JordinOverton/Learnsat_Hardware/README.md

# LearnSAT Hardware GitHub Repository

## All files related to the OBC, Boba, and PoBoI are located in their respective folders

## Please ensure all commits have MEANINGFUL descriptions behind what has been changed
