JordinOverton/Learnsat_Hardware/BoBa/BoBa.kicad_pcb

## KiCad design BoBa/BoBa.kicad_pcb (2026-11-11)

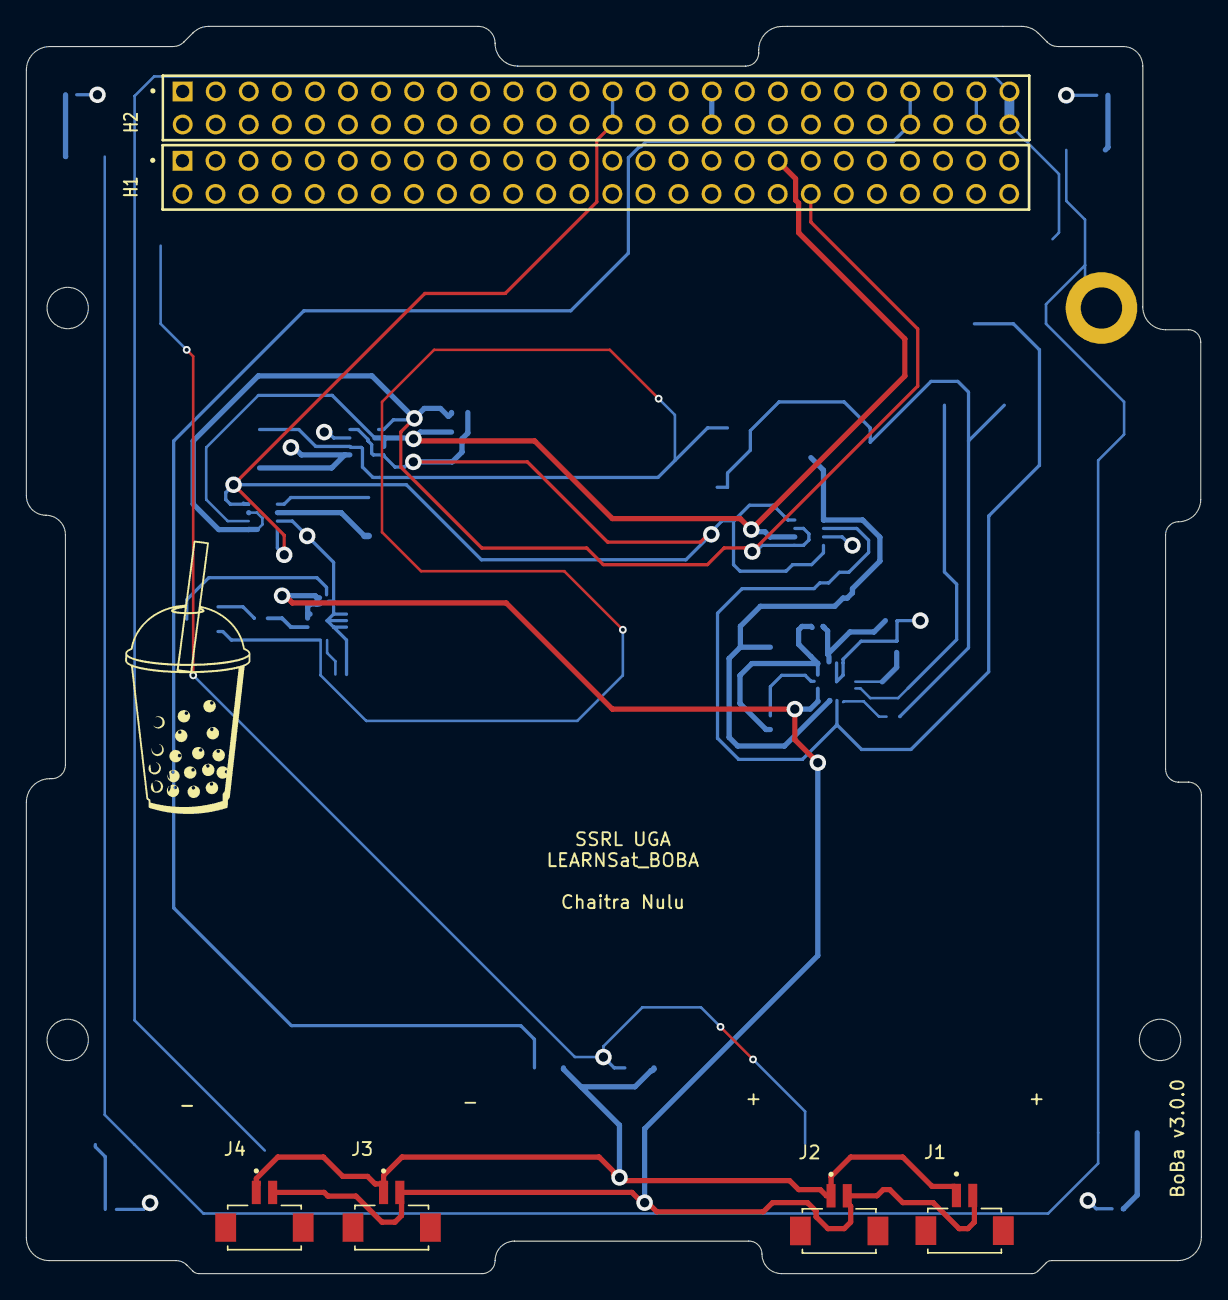
[picture p1: board BoBa.kicad_pcb from above]

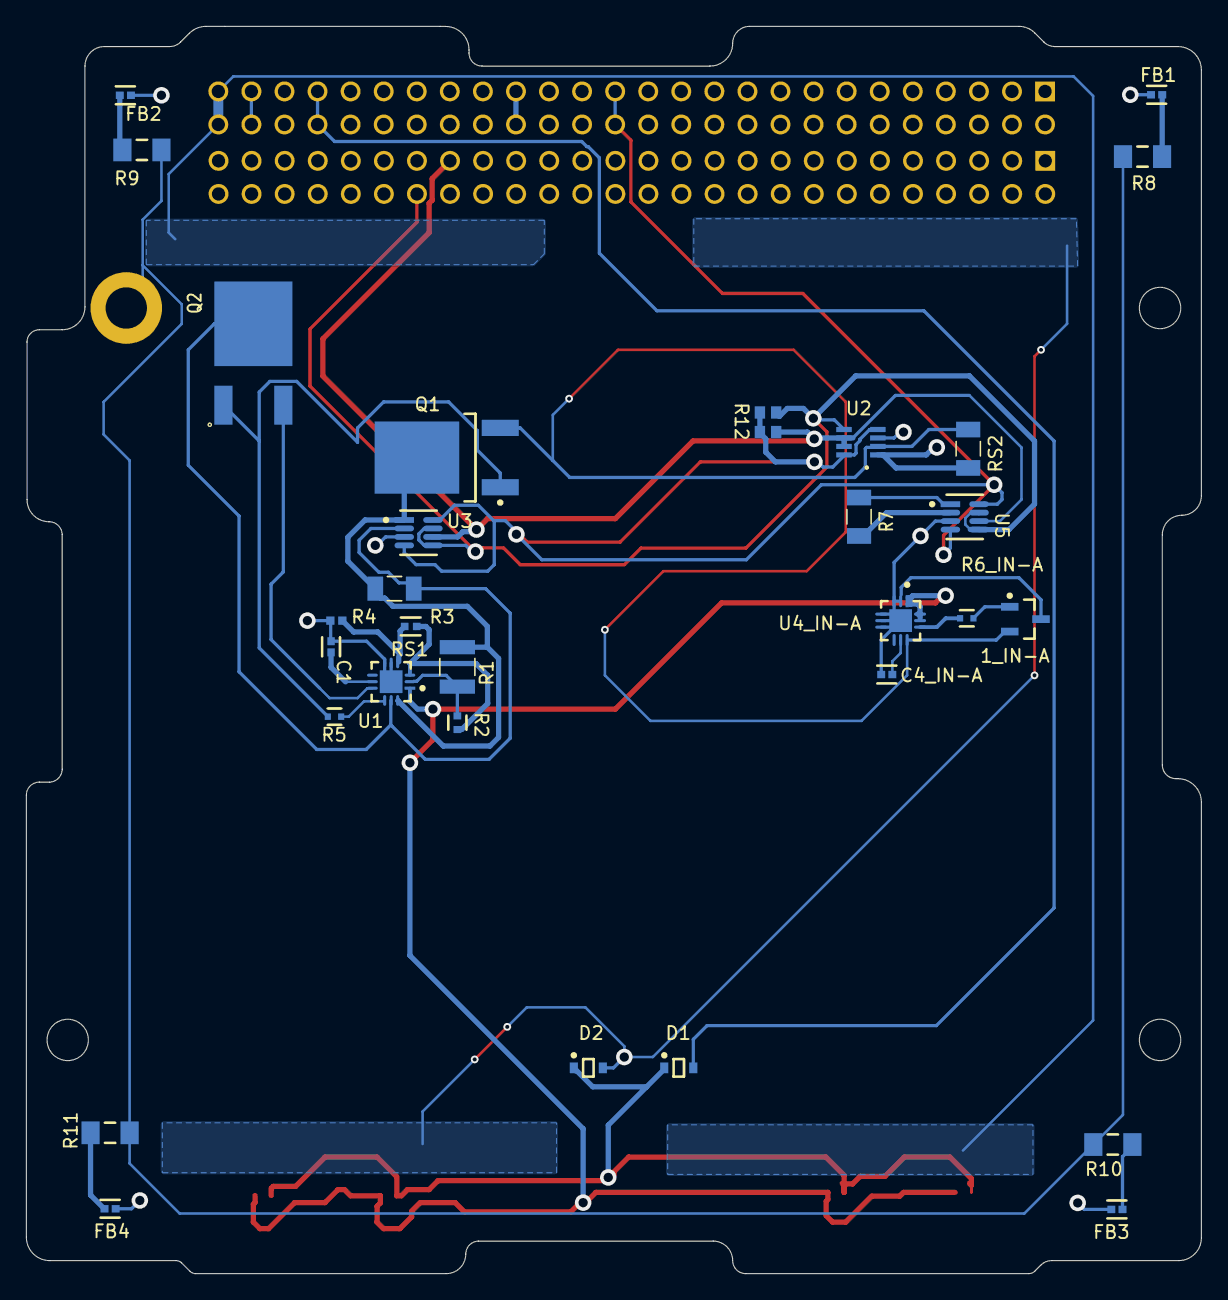
[picture p2: board BoBa.kicad_pcb from below]

Board: 4 copper layers, 90.3 x 95.8 mm, 37 parts (31 on the bottom side), 31 nets.

Parts:
1_IN-A: 2N7002; INF-PG-SOT23_M
  : CRCW06034K70FKTA; RESC1609X50X30NL10T20
C1, C4_IN-A: GRM155R71H472KA01D; FP-GRM155-0_05-IPC_B
D1, D2: BAT54HT1G; ONSC-SOD-323-2-477-02_V
FB1, FB2, FB3, FB4: BLM15AG102SN1D; FP-BLM15-0_05-IPC_B
H1, H2: SSQ-126-X-G-D; SAMTEC_SSQ-126-X-G-D
J1, J2, J3, J4: DF13C-2P-1.25V(21); HRS_DF13C-2P-1.25V(21)
Q1: FQD13N06LTM; FAIR-TO-252-3_V
Q2: FQD13N06LTM; TO229P991X239-3N
R1: CRCW1210900RFKTA; RESC3225X60N
R2: RG1005N-202-B-T5; FP-RG1005-MFG
R3: RG1005N-183-W-T5; FP-RG1005-IPC_B
R4: 96kOhm Resistor; CAPC1005X06N
R5, R6_IN-A: ERJ-2RKF10R0X; FP-ERJ2RK-MFG
R7: PE1206DRM470R025L1; RESC3216X89N
R8, R9, R10, R11: Resistor 1k +/-1% 1206 250 mW; RESC3116X70X50ML13T20
R12: CRCW06034K70FKTA; RESC1609X50X30NL10T20
RS1, RS2: PE1206DRM470R025L; RESC3216X89N
U1: LTC4231HUD-2#TRPBF; FP-UD-12-05-08-1855-IPC_B
U2: INA219; SOT23-8
U3, U5: INA219AIDCNR; FP-DCN0008A-IPC_B
U4_IN-A: LTC4231IUD-2#TRPBF; FP-UD-12-05-08-1855-IPC_A

Connections:
3V3_Secondary: .1, H2.27, H2.28, R12.1, U2.4, U2.8, U3.4, U3.8, U5.4, U5.8
3v3_Primary: H2.33, H2.34
Chassis GND: R8.2, R9.2, R10.2, R11.2
GND: 1_IN-A.3, C1.2, C4_IN-A.2, FB1.1, FB2.1, FB3.1, FB4.1, H2.13, H2.14, H2.29, H2.30, H2.31, H2.32, R4.2, U1.5, U1.6, U1.13, U2.3, U3.3, U4_IN-A.2, U4_IN-A.3, U4_IN-A.4, U4_IN-A.5, U4_IN-A.6, U4_IN-A.13, U5.3
G_IN-G: 1_IN-A.1, R6_IN-A.1
I2C Clock: .2, H1.40, U2.5, U3.5, U3.7, U5.5, U5.7
I2C Data: H1.37, R12.2, U2.6, U2.7, U3.6, U5.6
INHIBIT: J1.2, J2.2, J3.2, J4.2, U1.1, U4_IN-A.1, U4_IN-A.11, U4_IN-A.12
NetC1_1: C1.1, U1.8
NetC4_IN-G_1: C4_IN-A.1, U4_IN-A.8
NetD1_1: D1.1, D2.1, J1.1, J2.1, J3.1, J4.1
NetFB1_2: FB1.2, R8.1
NetFB2_2: FB2.2, R9.1
NetFB3_2: FB3.2, R10.1
NetFB4_2: FB4.2, R11.1
NetQ1_4: Q1.4, R1.2, RS1.1, U1.12, U3.1
NetQ2_1: Q1.1, Q2.1, R5.1
NetQ2_3: Q2.3, U1.9
NetQ2_4: Q2.4, RS1.2, U1.11, U3.2
NetR1_1: R1.1, R2.1, U1.2
NetR2_2: R2.2, R3.1, U1.3
NetR3_2: R3.2, R4.1, U1.4
NetR5_2: R5.2, U1.10
NetR6_IN-G_2: R6_IN-A.2, U4_IN-A.10
NetR7_1: R7.1, U5.2
NetR7_2: R7.2, U5.1
Pack+_Neg: H2.51, H2.52
Pack+_Pos: D2.2, RS2.1, U2.1
Pack-_Neg: 1_IN-A.2, Q1.3, RS2.2, U2.2, U4_IN-A.9
VBatt: H2.49, H2.50
Vmppt: D1.2, H2.45, H2.46
