JordinOverton/Learnsat_Hardware/OBC/OBC.kicad_pcb

## KiCad design OBC/OBC.kicad_pcb (2026-11-06)

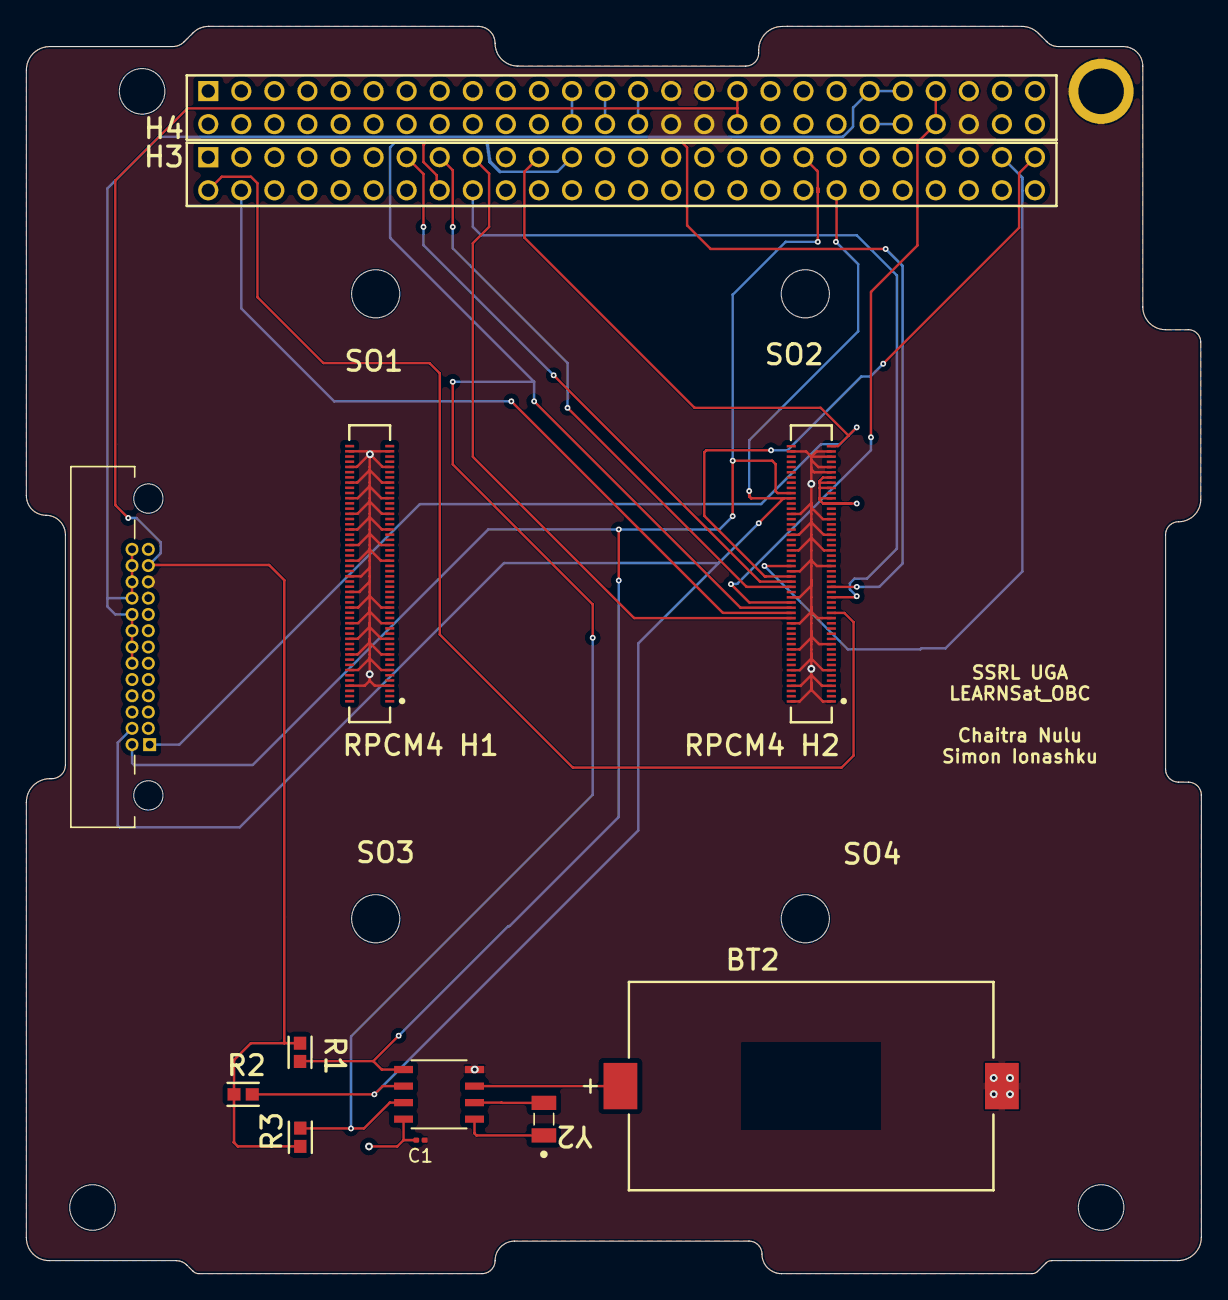
[picture p3: board OBC.kicad_pcb from above]

Board: 4 copper layers, 90.3 x 95.8 mm, 10 parts (0 on the bottom side), 21 nets.

Parts:
BT2: BA2032SM; MPD-BA2032SM_V
C1: 100nf; C_0201_0603Metric
H3, H4: SSQ-126-22-G-D; SMTC-SSQ-126-22-X-D
R1, R2, R3: Comment; FP-RMCF0603-IPC_B
RPCM4 H1, RPCM4 H2: Comment; FP-DF40HC_3_0_-100DS-0_4V-MFG
Y2: ECS-.327-12.5-34RR-TR; XTAL_ECS-.327-12.5-34RR-TR

Connections:
3V3_Primary: H4.33, H4.34, R1.1, R2.1, R3.1
3V3_Secondary: H4.27, H4.28
5V_Primary: C1.1, H4.23, H4.24, RPCM4 H2.77, RPCM4 H2.79, RPCM4 H2.83, RPCM4 H2.85, RPCM4 H2.87
5V_Secondary: H4.25, H4.26
GND: BT2.2, C1.2, H4.29, H4.30, H4.31, H4.32, H4.47, H4.48, RPCM4 H1.7, RPCM4 H1.8, RPCM4 H1.13, RPCM4 H1.14, RPCM4 H1.19, RPCM4 H1.20, RPCM4 H1.25, RPCM4 H1.26, RPCM4 H1.31, RPCM4 H1.32, RPCM4 H1.37, RPCM4 H1.38, RPCM4 H1.44, RPCM4 H1.50, RPCM4 H1.55, RPCM4 H1.56, RPCM4 H1.61, RPCM4 H1.62, RPCM4 H1.67, RPCM4 H1.68, RPCM4 H1.73, RPCM4 H1.74, RPCM4 H1.79, RPCM4 H1.80, RPCM4 H1.85, RPCM4 H1.86, RPCM4 H1.91, RPCM4 H1.92, RPCM4 H1.97, RPCM4 H1.98, RPCM4 H2.1, RPCM4 H2.2, RPCM4 H2.7, RPCM4 H2.8, RPCM4 H2.13, RPCM4 H2.14, RPCM4 H2.22, RPCM4 H2.23, RPCM4 H2.32, RPCM4 H2.33, RPCM4 H2.42, RPCM4 H2.52, RPCM4 H2.53, RPCM4 H2.59, RPCM4 H2.60, RPCM4 H2.65, RPCM4 H2.66, RPCM4 H2.71, RPCM4 H2.74, RPCM4 H2.89, RPCM4 H2.91, RPCM4 H2.95, RPCM4 H2.97, RPCM4 H2.98
GPIO 4: H3.49, RPCM4 H2.54
GPIO 5: H3.17, RPCM4 H2.34
GPIO 17: H3.51, RPCM4 H2.50
GPIO 22: H3.15, RPCM4 H2.46
GPIO 24: H3.16, RPCM4 H2.45
GPIO 25: H3.18, RPCM4 H2.41
GPIO 27: H3.13, RPCM4 H2.48
OBC_HB: H3.23, R3.2, RPCM4 H2.38
OBC_RST: H3.21, RPCM4 H2.99
SCL: H3.40, R2.2, RPCM4 H2.80
SDA: H3.37, R1.2, RPCM4 H2.82
UART_RX: H3.4, RPCM4 H2.36
UART_TX: H3.2, RPCM4 H2.35
VBATT_Primary: H4.41, H4.43
VBATT_Secondary: H4.42, H4.44
Vmppt: H4.45, H4.46, RPCM4 H2.40
