JordinOverton/Learnsat_Hardware/(commit log)

2026-10-13 OBC DRC cleanup 10/12 Arman Aryafar
    - BT: moved center + marker from F.Courtyard to F.Fab, redrew courtyard as a closed rectangle
    - H1/H2: excluded courtyard overlap warning (intentionally stacked headers)
    - H1/H2: moved reference labels off the silkscreen outline
    - Set 'Footprint not found in libraries' check to ignore (Vault library not in repo)
    [OBC.kicad_pcb]
2026-10-14 Update BoBa.kicad_pcb
    Resized silkscreen text to 1.0mm / 0.15mm
    [BoBa.kicad_pcb]
2026-10-14 changed clearance violation
    [BoBa.kicad_pcb]
2026-10-14 fixed some violations
    [BoBa.kicad_pcb]
2026-10-14 Configure Vault footprint library and reduce DRC warnings from 92 -> 66
    [BoBa.kicad_pcb, BoBa.kicad_sch, INA.kicad_sch]
2026-10-15 OBC thermal fixes 10/14 Arman Aryafar
    - Set pads to solid zone connection to fix starved thermal warnings: connector pad 11, H2 pins 24, 30, 32, 48
    - OBC DRC now 0 violations
    [OBC.kicad_pcb]
2026-10-21 malformed-outline warnings fixed
    [BoBa.kicad_pcb]
2026-10-21 Updated footprint mappings and reduce DRC violations. Currently at 26 warnings
    [BoBa.kicad_pcb]
2026-10-21 fixed all errors
    [BoBa.kicad_pcb]
2026-10-21 fixed errors, changes some traces, 33 warnings remaining
    [BoBa.kicad_pcb]
2026-10-22 Clean up GND routing to RPCM4 H1/H2 headers
    - Removed 45 degree GND traces running to the H1 and H2 header pads
    - Replaced long GND traces with short stubs and vias down to the
    GND plane (layer 2)
    - Shorter return paths and less top layer clutter around the headers
    [OBC.kicad_pcb]
2026-10-22 Clean up GND routing on RPCM4 H1 header
    - Removed unnecessary long GND traces on H1
    - Replaced them with short stubs and vias down to the GND plane
    (layer 2)
    [OBC.kicad_pcb]
2026-10-28 Fix footprint library issues and reduce DRC warnings 26 -> 15
    [BoBa.kicad_pcb]
2026-10-28 Update 6 footprints from Vault library
    Re-synced D1, D2, 1_IN-A, R4, Q1, R12 with their Vault library
    versions. Old board copies had malformed (unclosed) courtyards and
    didn't match the library. Clears 12 DRC warnings (27 -> 15).
    Positions and connections unchanged; 0 unconnected items.
2026-10-28 Fix solder paste on U1 and U4_IN-A exposed pads
    [BoBa.kicad_pcb]
2026-10-28 Changed footprint assignemnts and reduced warnings. 10 left.
    [BoBa.kicad_pcb]
2026-10-28 POBOI 4S updates: remove 12V/TVS sheets, fix VBATT dividers, INA219 addresses, U26
    POBOI changes 10/28 Simon Ionashku
    - Deleted the separate copy of the PCB file (BoardFix, it was an older version)
    - Removed these sheets from the schematic and the board (no use for them anymore)
    - 12 PRIMARY
    - 12V BOOST
    - 12V SECONDARY
    - our 4S pack is already 12-16.8V so boosting to 12V does nothing, and the LM2622 is only rated for 12V in anyway
    - anything that needs ~12V can just use the VBATT Primary/Secondary rails
    - also deleted the "NEED TO ADD 12V COMPATIBILITY" note on the STM32 sheet
    - TVS_DIODES
    - they weren't actually connected to anything (cathodes were all n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
    [12VPrimary.kicad_sch, 12V_BOOST.kicad_sch, 12V_Secondary.kicad_sch, 3V3Primary.kicad_sch, 3V3Secondary.kicad_sch, 3V3_Buck.kicad_sch, 5VPrimary.kicad_sch, 5VSecondary.kicad_sch]
2026-11-01 Made changes to OBC with RTC logic pins pulled up to 3.3V instead of 5V on a separate branch before merging to main branch
    [OBC.kicad_pcb]
2026-11-05 Added coupling capacitor and updated schematic accordingly
    [OBC.kicad_pcb, RTC.kicad_sch]
2026-11-05 add OBC footprint library (OBC_Vault.pretty + fp-lib-table)
2026-11-05 Updated resistor numbers on schematic
    [RTC.kicad_sch]
2026-11-06 Renamed BAT, Y, H1 and H2 to match the correct label on the schematic
    [CM4.kicad_sch, OBC.kicad_pcb]
2026-11-11 fixed mounting holes
    [BoBa.kicad_pcb]
2026-11-11 footprint warning left, 0 errors 1 warning
    [BoBa.kicad_pcb]
2026-11-11 exluded footprint error, 0 errors 0 warnings left
